abishek14-code/LOW-COST-LIFI-TRANSRECIEVER-4-LAYER-PCB/BOM.csv

Reference | Value | Footprint
J1 | 5V regulated input | SAMTEC SSW-102-03-T-S
F1 | MF-NSMF025X-2 250mA | BOURNS MF-NSMF025X
D1 | SS14 | DO214AC SMA
U1 | AP2112K-3.3TRG1 | DIODES SOT-23-5 K
C1 | 4.7uF 10V X7R | CAP 0805_2012
C2 | 4.7uF 10V X7R | CAP 0805_2012
R1 | 10R | RES 0603_1608
C3 | 10uF 10V X7R | CAP 0805_2012
C4 | 100nF | CAP 0603_1608
U2 | STM32F103C8T6 | ST LQFP-48 7x7MM
Y1 | ABLS-8.000MHZ-B2-T | ABRACON ABLS
C5 | 30pF C0G (tune) | CAP 0603_1608
C6 | 30pF C0G (tune) | CAP 0603_1608
R2 | 10k | RES 0603_1608
C7 | 100nF | CAP 0603_1608
R3 | 10k | RES 0603_1608
R4 | 10k | RES 0603_1608
J2 | SWD 3.3V reference | SAMTEC SSW-105-03-T-S
J3 | UART 3.3V logic | SAMTEC SSW-103-03-T-S
R5 | 100R | RES 0603_1608
R6 | 100R | RES 0603_1608
D2 | PESD3V3S2BT | NEXPERIA SOT-23-3
C8 | 100nF | CAP 0603_1608
C9 | 100nF | CAP 0603_1608
C10 | 100nF | CAP 0603_1608
C11 | 100nF | CAP 0603_1608
C12 | 4.7uF | CAP 0805_2012
C13 | 100nF | CAP 0603_1608
D3 | GREEN status LED | LED 0603_1608 GREEN
R7 | 1k | RES 0603_1608
D4 | GREEN power LED | LED 0603_1608 GREEN
R8 | 2.2k | RES 0603_1608
Q1 | AO3400A | DIODES SOT-23-3
D5 | WP7113SRD/D visible red | KINGBRIGHT WP7113SRD
R9 | 150R 0.25W | RES 1206_3216
R10 | 100R | RES 0603_1608
R11 | 100k | RES 0603_1608
C14 | 10uF 10V | CAP 0805_2012
R12 | 10k 0.1% | RES 0603_1608
R13 | 10k 0.1% | RES 0603_1608
C15 | 10uF | CAP 0805_2012
U3 | OPA2320AID | TI SOIC-8 D
D6 | BPW34 photodiode | VISHAY BPW34
R14 | 100k 1% | RES 0603_1608
C16 | 22pF C0G (tune) | CAP 0603_1608
C17 | 100nF | CAP 0603_1608
C18 | 10nF C0G | CAP 0603_1608
R15 | 100k | RES 0603_1608
R16 | 1k | RES 0603_1608
R17 | 20k | RES 0603_1608
C19 | 100pF C0G | CAP 0603_1608
R18 | 10k | RES 0603_1608
U4 | TLV3201AIDBVR | TI SOT-23-5 DBV
R19 | 2.2M | RES 0603_1608
R20 | 100R | RES 0603_1608
R21 | 10k | RES 0603_1608
C20 | 1nF | CAP 0603_1608
C21 | 100nF | CAP 0603_1608
TP1 | GND | TEST PAD 1MM
TP2 | V5_PROTECTED | TEST PAD 1MM
TP3 | V3V3 | TEST PAD 1MM
TP4 | VREF | TEST PAD 1MM
TP5 | TIA_OUT | TEST PAD 1MM
TP6 | RX_FILTER | TEST PAD 1MM
TP7 | OPT_TX | TEST PAD 1MM
TP8 | OPT_RX | TEST PAD 1MM
