abishek14-code/LOW-COST-LIFI-TRANSRECIEVER-4-LAYER-PCB/Component_Pin_Map.csv

Reference | Component | Pin | Pin function | Net
J1 | 5V regulated input | 1 | 5V | VIN_5V
J1 | 5V regulated input | 2 | GND | GND
F1 | MF-NSMF025X-2 250mA | 1 | 1 | VIN_5V
F1 | MF-NSMF025X-2 250mA | 2 | 2 | FUSED_5V
D1 | SS14 | 1 | K | V5_PROTECTED
D1 | SS14 | 2 | A | FUSED_5V
U1 | AP2112K-3.3TRG1 | 1 | VIN | V5_PROTECTED
U1 | AP2112K-3.3TRG1 | 2 | GND | GND
U1 | AP2112K-3.3TRG1 | 3 | EN | V5_PROTECTED
U1 | AP2112K-3.3TRG1 | 4 | NC
U1 | AP2112K-3.3TRG1 | 5 | VOUT | V3V3
C1 | 4.7uF 10V X7R | 1 | 1 | V5_PROTECTED
C1 | 4.7uF 10V X7R | 2 | 2 | GND
C2 | 4.7uF 10V X7R | 1 | 1 | V3V3
C2 | 4.7uF 10V X7R | 2 | 2 | GND
R1 | 10R | 1 | 1 | V3V3
R1 | 10R | 2 | 2 | V3V3_A
C3 | 10uF 10V X7R | 1 | 1 | V3V3_A
C3 | 10uF 10V X7R | 2 | 2 | GND
C4 | 100nF | 1 | 1 | V3V3_A
C4 | 100nF | 2 | 2 | GND
U2 | STM32F103C8T6 | 1 | VBAT | V3V3
U2 | STM32F103C8T6 | 2 | PC13 | STATUS
U2 | STM32F103C8T6 | 3 | PC14
U2 | STM32F103C8T6 | 4 | PC15
U2 | STM32F103C8T6 | 5 | PD0 | OSC_IN
U2 | STM32F103C8T6 | 6 | PD1 | OSC_OUT
U2 | STM32F103C8T6 | 7 | NRST | NRST
U2 | STM32F103C8T6 | 8 | VSSA | GND
U2 | STM32F103C8T6 | 9 | VDDA | V3V3_A
U2 | STM32F103C8T6 | 10 | PA0 | OPT_RX
U2 | STM32F103C8T6 | 11 | PA1 | RX_MONITOR
U2 | STM32F103C8T6 | 12 | PA2 | HOST_TX
U2 | STM32F103C8T6 | 13 | PA3 | HOST_RX
U2 | STM32F103C8T6 | 14 | PA4
U2 | STM32F103C8T6 | 15 | PA5
U2 | STM32F103C8T6 | 16 | PA6
U2 | STM32F103C8T6 | 17 | PA7
U2 | STM32F103C8T6 | 18 | PB0
U2 | STM32F103C8T6 | 19 | PB1
U2 | STM32F103C8T6 | 20 | PB2 | BOOT1
U2 | STM32F103C8T6 | 21 | PB10
U2 | STM32F103C8T6 | 22 | PB11
U2 | STM32F103C8T6 | 23 | VSS1 | GND
U2 | STM32F103C8T6 | 24 | VDD1 | V3V3
U2 | STM32F103C8T6 | 25 | PB12
U2 | STM32F103C8T6 | 26 | PB13
U2 | STM32F103C8T6 | 27 | PB14
U2 | STM32F103C8T6 | 28 | PB15
U2 | STM32F103C8T6 | 29 | PA8 | OPT_TX
U2 | STM32F103C8T6 | 30 | PA9
U2 | STM32F103C8T6 | 31 | PA10
U2 | STM32F103C8T6 | 32 | PA11
U2 | STM32F103C8T6 | 33 | PA12
U2 | STM32F103C8T6 | 34 | PA13 | SWDIO
U2 | STM32F103C8T6 | 35 | VSS2 | GND
U2 | STM32F103C8T6 | 36 | VDD2 | V3V3
U2 | STM32F103C8T6 | 37 | PA14 | SWCLK
U2 | STM32F103C8T6 | 38 | PA15
U2 | STM32F103C8T6 | 39 | PB3
U2 | STM32F103C8T6 | 40 | PB4
U2 | STM32F103C8T6 | 41 | PB5
U2 | STM32F103C8T6 | 42 | PB6
U2 | STM32F103C8T6 | 43 | PB7
U2 | STM32F103C8T6 | 44 | BOOT0 | BOOT0
U2 | STM32F103C8T6 | 45 | PB8
U2 | STM32F103C8T6 | 46 | PB9
U2 | STM32F103C8T6 | 47 | VSS3 | GND
U2 | STM32F103C8T6 | 48 | VDD3 | V3V3
Y1 | ABLS-8.000MHZ-B2-T | 1 | 1 | OSC_IN
Y1 | ABLS-8.000MHZ-B2-T | 2 | 2 | OSC_OUT
C5 | 30pF C0G (tune) | 1 | 1 | OSC_IN
C5 | 30pF C0G (tune) | 2 | 2 | GND
C6 | 30pF C0G (tune) | 1 | 1 | OSC_OUT
C6 | 30pF C0G (tune) | 2 | 2 | GND
R2 | 10k | 1 | 1 | V3V3
R2 | 10k | 2 | 2 | NRST
C7 | 100nF | 1 | 1 | NRST
C7 | 100nF | 2 | 2 | GND
R3 | 10k | 1 | 1 | BOOT0
R3 | 10k | 2 | 2 | GND
R4 | 10k | 1 | 1 | BOOT1
R4 | 10k | 2 | 2 | GND
J2 | SWD 3.3V reference | 1 | VTREF | V3V3
J2 | SWD 3.3V reference | 2 | SWDIO | SWDIO
J2 | SWD 3.3V reference | 3 | GND | GND
J2 | SWD 3.3V reference | 4 | SWCLK | SWCLK
J2 | SWD 3.3V reference | 5 | NRST | NRST
J3 | UART 3.3V logic | 1 | GND | GND
J3 | UART 3.3V logic | 2 | TX_OUT | UART_TX
J3 | UART 3.3V logic | 3 | RX_IN | UART_RX
R5 | 100R | 1 | 1 | HOST_TX
R5 | 100R | 2 | 2 | UART_TX
R6 | 100R | 1 | 1 | UART_RX
R6 | 100R | 2 | 2 | HOST_RX
D2 | PESD3V3S2BT | 1 | IO1 | UART_TX
D2 | PESD3V3S2BT | 2 | IO2 | UART_RX
D2 | PESD3V3S2BT | 3 | GND | GND
C8 | 100nF | 1 | 1 | V3V3
C8 | 100nF | 2 | 2 | GND
C9 | 100nF | 1 | 1 | V3V3
C9 | 100nF | 2 | 2 | GND
C10 | 100nF | 1 | 1 | V3V3
C10 | 100nF | 2 | 2 | GND
C11 | 100nF | 1 | 1 | V3V3
C11 | 100nF | 2 | 2 | GND
C12 | 4.7uF | 1 | 1 | V3V3
C12 | 4.7uF | 2 | 2 | GND
C13 | 100nF | 1 | 1 | V3V3_A
C13 | 100nF | 2 | 2 | GND
D3 | GREEN status LED | 1 | K | STATUS
D3 | GREEN status LED | 2 | A | STATUS_A
R7 | 1k | 1 | 1 | V3V3
R7 | 1k | 2 | 2 | STATUS_A
D4 | GREEN power LED | 1 | K | GND
D4 | GREEN power LED | 2 | A | POWER_A
R8 | 2.2k | 1 | 1 | V3V3
R8 | 2.2k | 2 | 2 | POWER_A
Q1 | AO3400A | 1 | G | TX_GATE
Q1 | AO3400A | 2 | S | GND
Q1 | AO3400A | 3 | D | LED_K
D5 | WP7113SRD/D visible red | 1 | K | LED_K
D5 | WP7113SRD/D visible red | 2 | A | LED_A
R9 | 150R 0.25W | 1 | 1 | V5_PROTECTED
R9 | 150R 0.25W | 2 | 2 | LED_A
R10 | 100R | 1 | 1 | OPT_TX
R10 | 100R | 2 | 2 | TX_GATE
R11 | 100k | 1 | 1 | TX_GATE
R11 | 100k | 2 | 2 | GND
C14 | 10uF 10V | 1 | 1 | V5_PROTECTED
C14 | 10uF 10V | 2 | 2 | GND
R12 | 10k 0.1% | 1 | 1 | V3V3_A
R12 | 10k 0.1% | 2 | 2 | VREF
R13 | 10k 0.1% | 1 | 1 | VREF
R13 | 10k 0.1% | 2 | 2 | GND
C15 | 10uF | 1 | 1 | VREF
C15 | 10uF | 2 | 2 | GND
U3 | OPA2320AID | 1 | OUT_A | TIA_OUT
U3 | OPA2320AID | 2 | IN_A- | TIA_SUM
U3 | OPA2320AID | 3 | IN_A+ | VREF
U3 | OPA2320AID | 4 | V- | GND
U3 | OPA2320AID | 5 | IN_B+ | RX_AC
U3 | OPA2320AID | 6 | IN_B- | GAIN_FB
U3 | OPA2320AID | 7 | OUT_B | RX_FILTER
U3 | OPA2320AID | 8 | V+ | V3V3_A
D6 | BPW34 photodiode | 1 | K | V3V3_A
D6 | BPW34 photodiode | 2 | A | TIA_SUM
R14 | 100k 1% | 1 | 1 | TIA_OUT
R14 | 100k 1% | 2 | 2 | TIA_SUM
C16 | 22pF C0G (tune) | 1 | 1 | TIA_OUT
C16 | 22pF C0G (tune) | 2 | 2 | TIA_SUM
C17 | 100nF | 1 | 1 | V3V3_A
C17 | 100nF | 2 | 2 | GND
C18 | 10nF C0G | 1 | 1 | TIA_OUT
C18 | 10nF C0G | 2 | 2 | RX_AC
R15 | 100k | 1 | 1 | RX_AC
R15 | 100k | 2 | 2 | VREF
R16 | 1k | 1 | 1 | GAIN_FB
R16 | 1k | 2 | 2 | VREF
R17 | 20k | 1 | 1 | RX_FILTER
R17 | 20k | 2 | 2 | GAIN_FB
C19 | 100pF C0G | 1 | 1 | RX_FILTER
C19 | 100pF C0G | 2 | 2 | GAIN_FB
R18 | 10k | 1 | 1 | RX_FILTER
R18 | 10k | 2 | 2 | CMP_PLUS
U4 | TLV3201AIDBVR | 1 | OUT | CMP_OUT
U4 | TLV3201AIDBVR | 2 | GND | GND
U4 | TLV3201AIDBVR | 3 | IN+ | CMP_PLUS
U4 | TLV3201AIDBVR | 4 | IN- | VREF
U4 | TLV3201AIDBVR | 5 | VCC | V3V3_A
R19 | 2.2M | 1 | 1 | CMP_OUT
R19 | 2.2M | 2 | 2 | CMP_PLUS
R20 | 100R | 1 | 1 | CMP_OUT
R20 | 100R | 2 | 2 | OPT_RX
R21 | 10k | 1 | 1 | RX_FILTER
R21 | 10k | 2 | 2 | RX_MONITOR
C20 | 1nF | 1 | 1 | RX_MONITOR
C20 | 1nF | 2 | 2 | GND
C21 | 100nF | 1 | 1 | V3V3_A
C21 | 100nF | 2 | 2 | GND
TP1 | GND | 1 | GND | GND
TP2 | V5_PROTECTED | 1 | V5_PROTECTED | V5_PROTECTED
TP3 | V3V3 | 1 | V3V3 | V3V3
TP4 | VREF | 1 | VREF | VREF
TP5 | TIA_OUT | 1 | TIA_OUT | TIA_OUT
TP6 | RX_FILTER | 1 | RX_FILTER | RX_FILTER
TP7 | OPT_TX | 1 | OPT_TX | OPT_TX
TP8 | OPT_RX | 1 | OPT_RX | OPT_RX
