abishek14-code/LOW-COST-LIFI-TRANSRECIEVER-4-LAYER-PCB/(list of files, drawings)

Other design files:
LiFi_Connected_no_dr.PcbDoc
LiFi_Optics.PcbLib
LiFi_Via_Types.PrjPcb
Transceiver_Connected.SchDoc
