abishek14-code/LOW-COST-LIFI-TRANSRECIEVER-4-LAYER-PCB/(commit log)

2026-10-31 Enhance README with PCB views and verification details
    Added PCB views and updated verification status in README.
2026-10-31 Fix image paths for PCB layout and assembly
    Updated image paths in README.md for PCB views.
2026-10-31 Fix image paths for PCB layout and assembly
    Updated image paths in README for PCB views.
2026-10-31 Fix PCB image links and README layout
